lhr-solar/VCAT-StrainGaugeBoard/StrainGaugeBoard.pdf

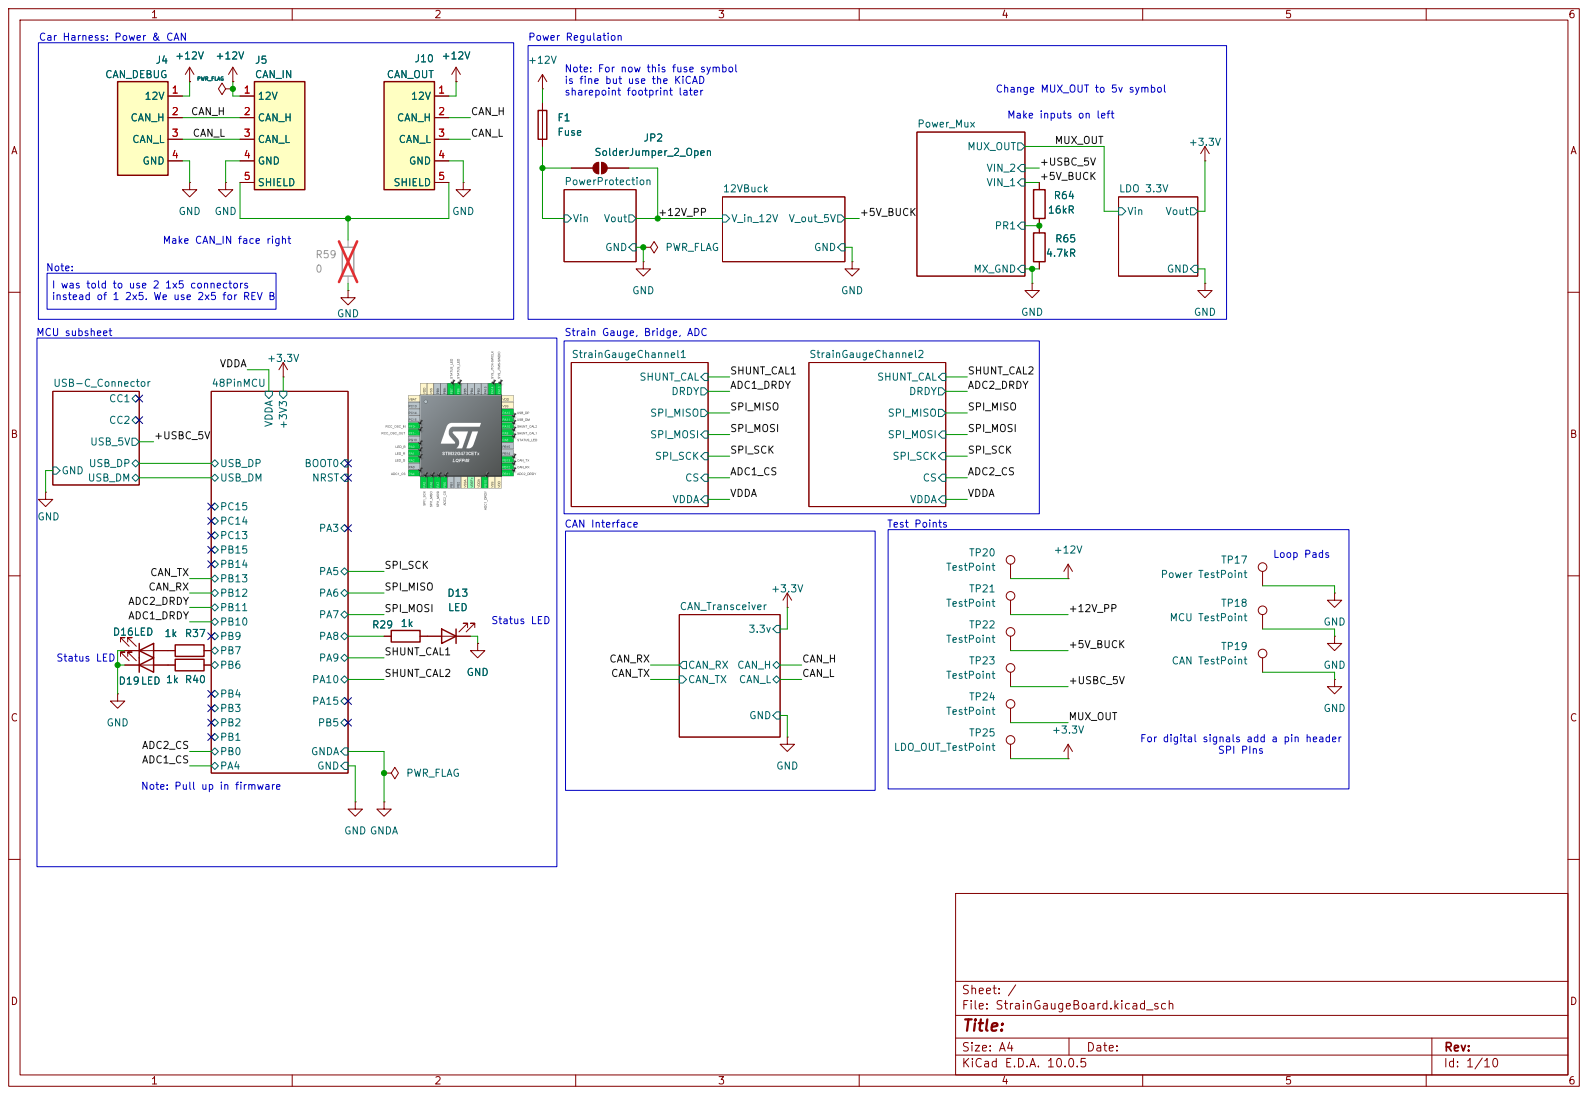
[picture p1: page 1]

Car Harness: Power & CAN

Note: For now this fuse symbol

I was told to use 2 1x5 connectors

Test Points Strain Gauge, Bridge, ADC

For digital signals add a pin header SPI PIns

Note: Pull up in firmware

Size: A4 | Rev:
KiCad E.D.A. 10.0.5 | Id: 1/10

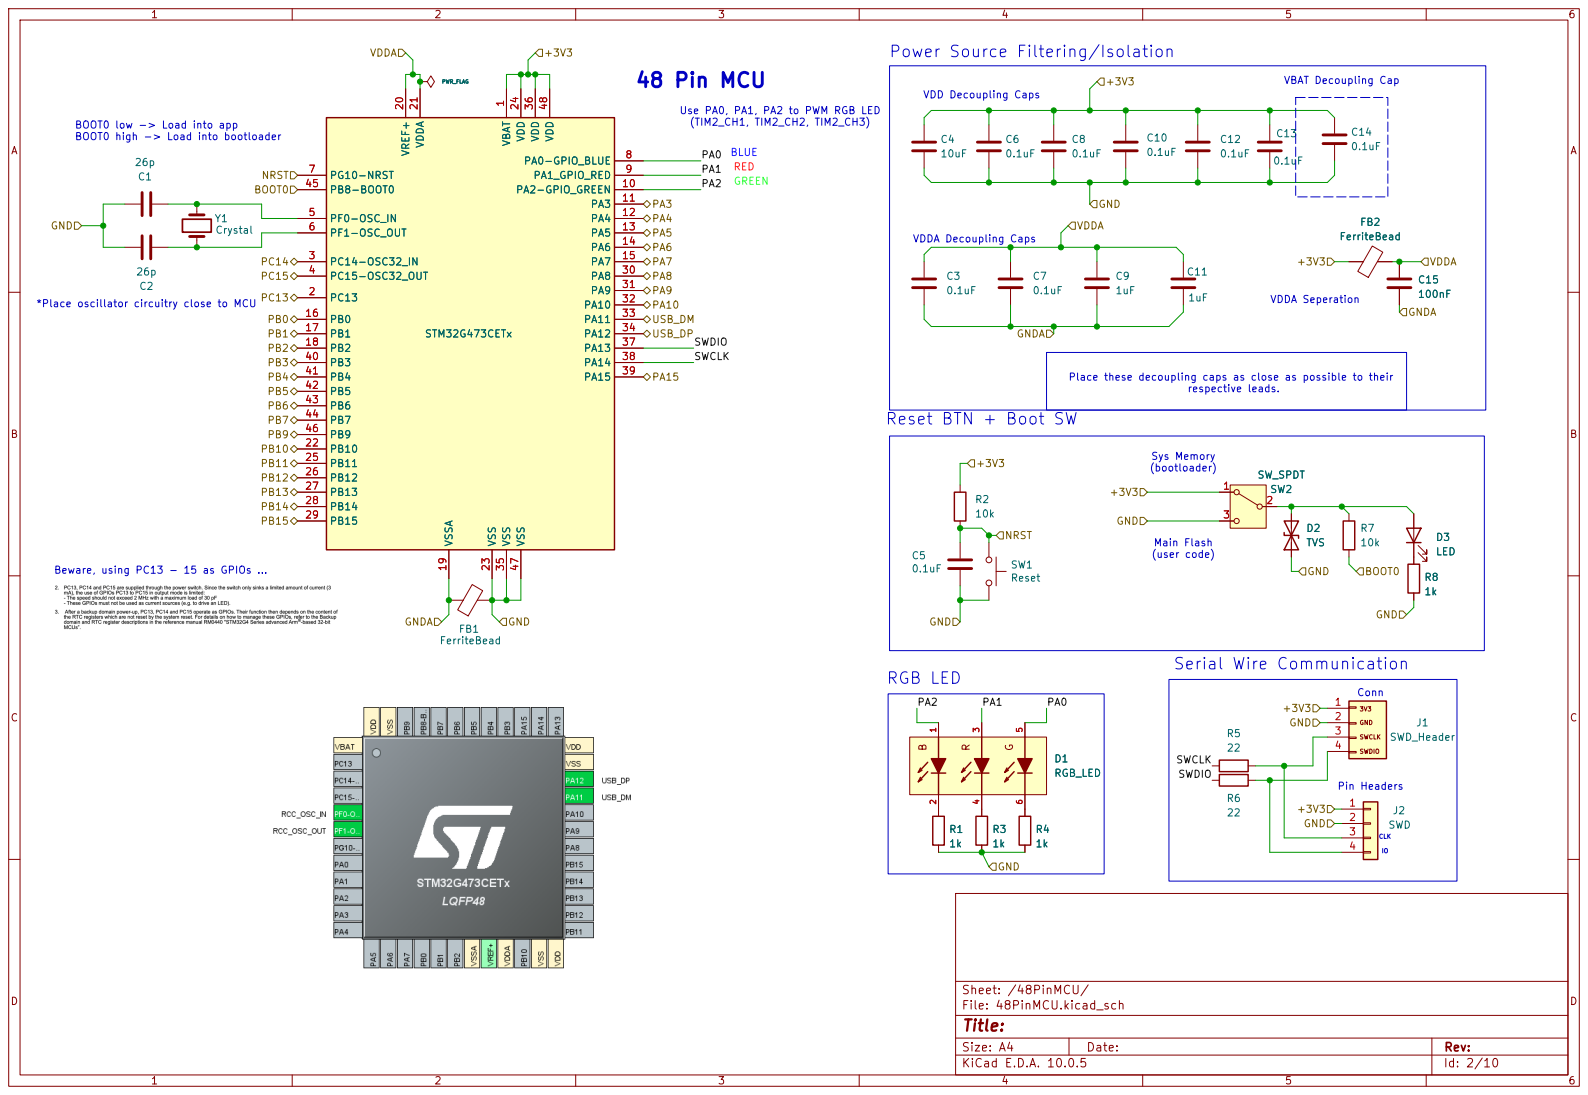
[picture p2: page 2]

*Place oscillator circuitry close to MCU

Place these decoupling caps as close as possible to their

respective leads. Sys Memory

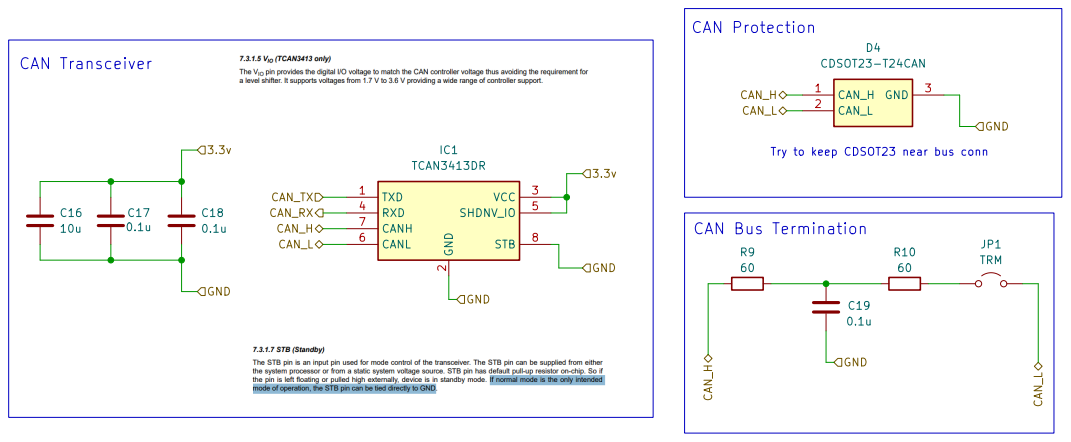
[picture p3: page 3]

Try to keep CDSOT23 near bus conn CAN Bus Termination

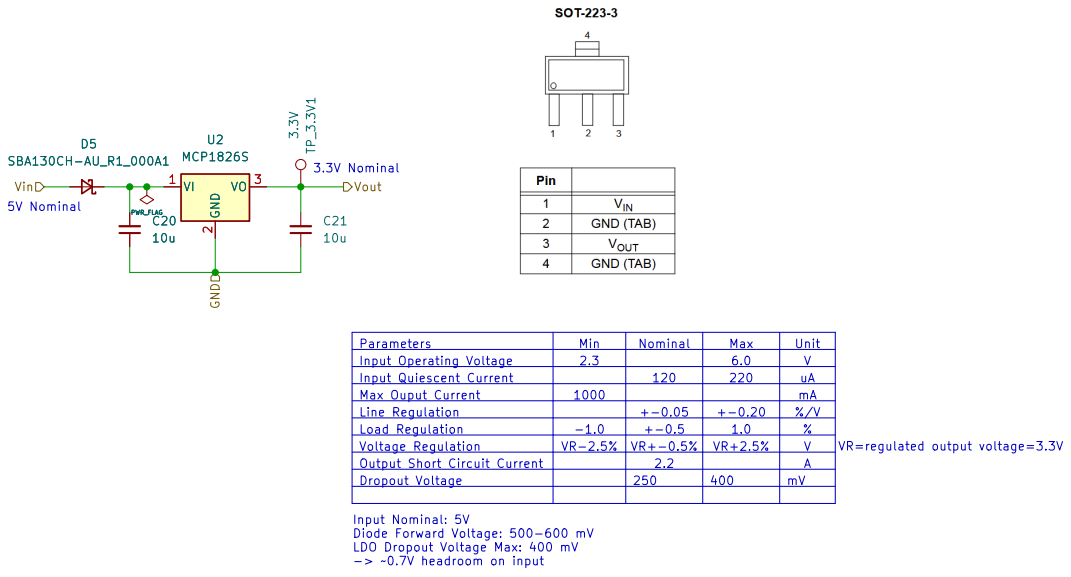
[picture p4: page 4]

VR=regulated output voltage=3.3V 3.3V Nominal D5

Input Operating Voltage | 2.3 | | 6.0 | V
Input Quiescent Current | 1000 | 120 | 220 | mA uA Max Ouput Current

Line Regulation | | +-0.05 | +-0.20 | %/V
Load Regulation | -1.0 | +-0.5 | 1.0 | %

Input Nominal: 5V Diode Forward Voltage: 500-600 mV

LDO Dropout Voltage Max: 400 mV -> ~0.7V headroom on input

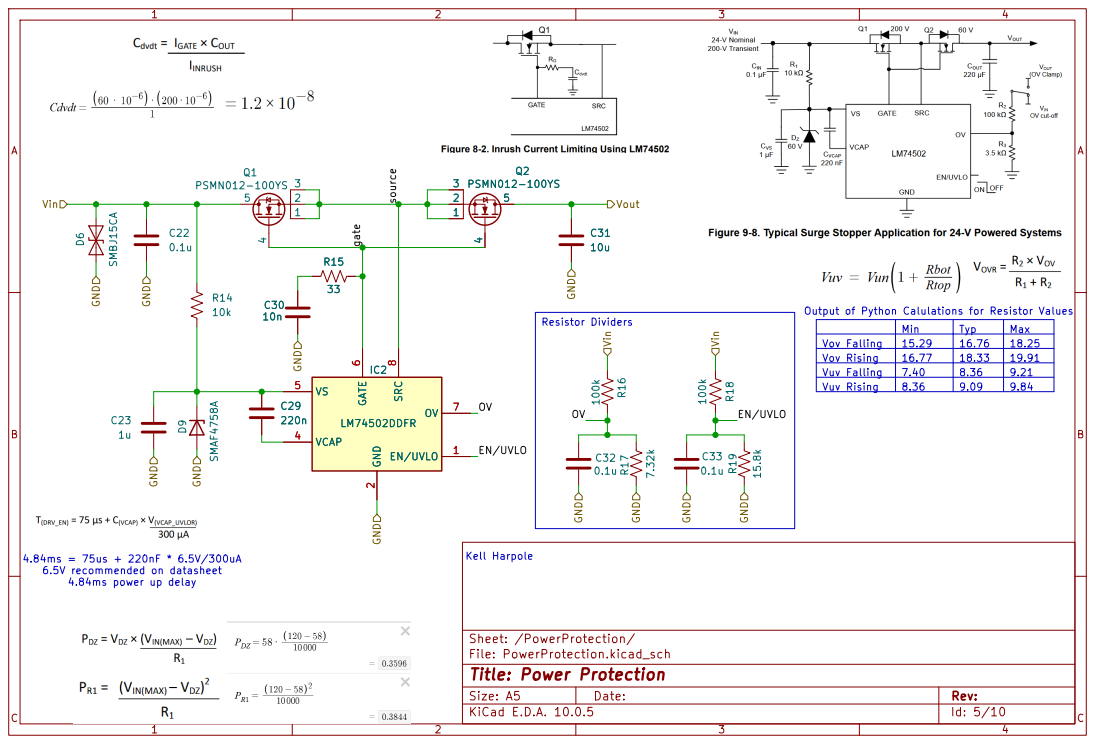
[picture p5: page 5]

Output of Python Calulations for Resistor Values C29

Vov Rising | 16.77 | 18.33 | 19.91
Vuv Falling | 7.40 | 8.36 | 9.21

Size: A5 | Rev: | C Date:
KiCad E.D.A. 10.0.5 | Id: 5/10

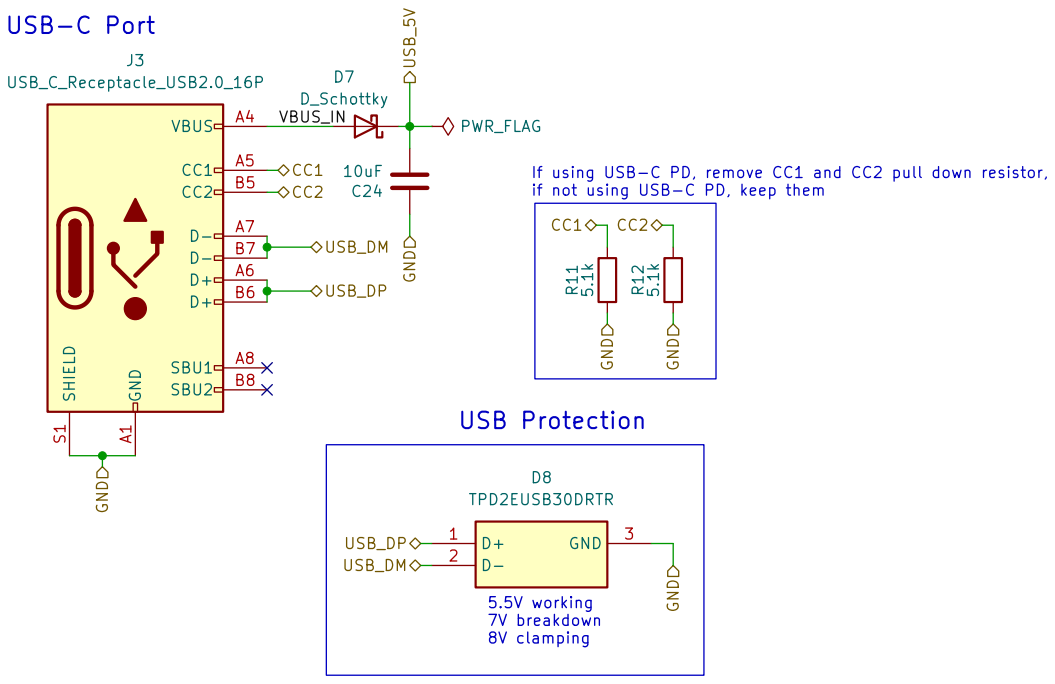
[picture p6: page 6]

If using USB-C PD, remove CC1 and CC2 pull down resistor,
if not using USB-C PD, keep them

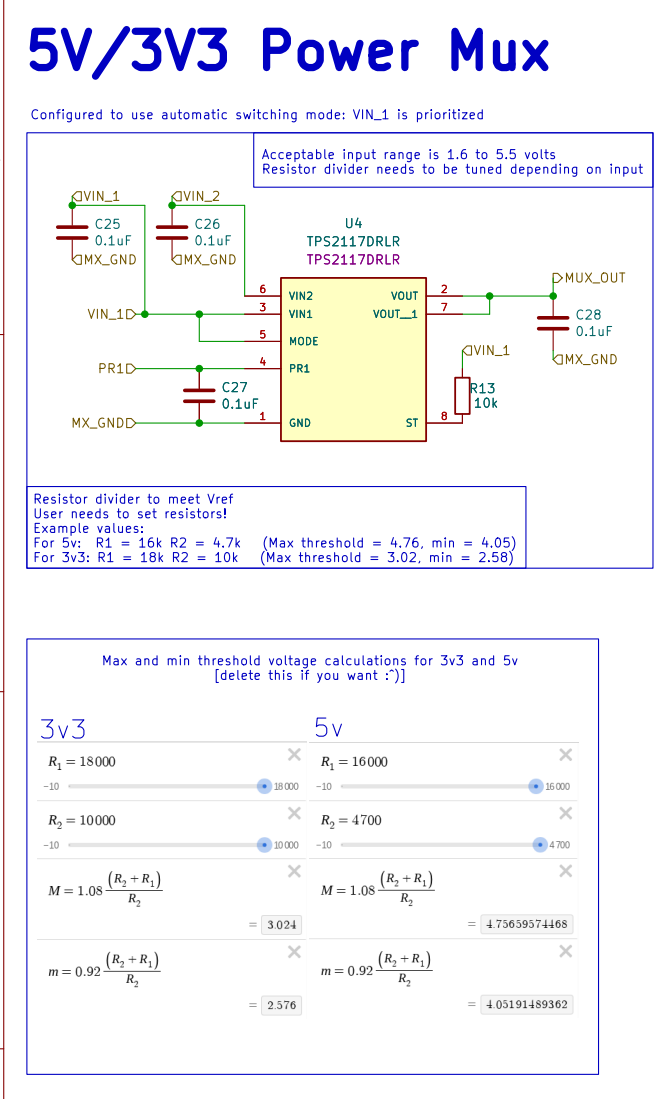
[picture p7: page 7]

Configured to use automatic switching mode: VIN_1 is prioritized Max and min threshold voltage calculations for 3v3 and 5v

Acceptable input range is 1.6 to 5.5 volts Resistor divider needs to be tuned depending on input
TPS2117DRLR

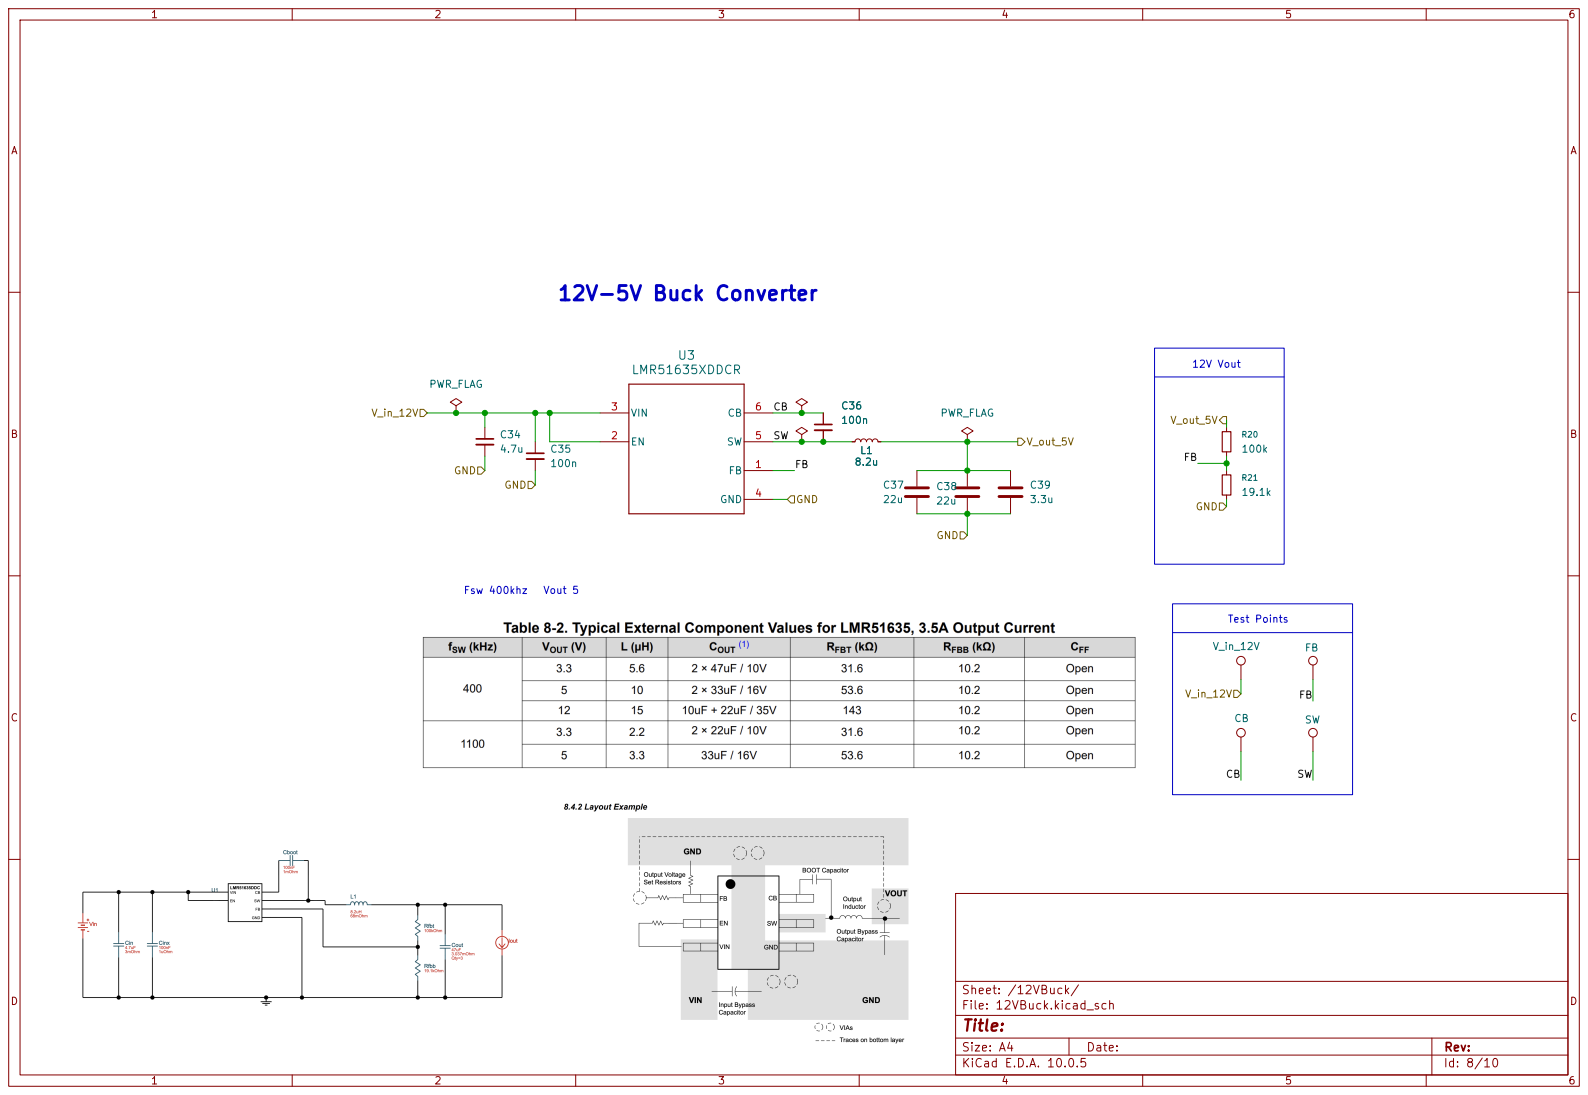
[picture p8: page 8]

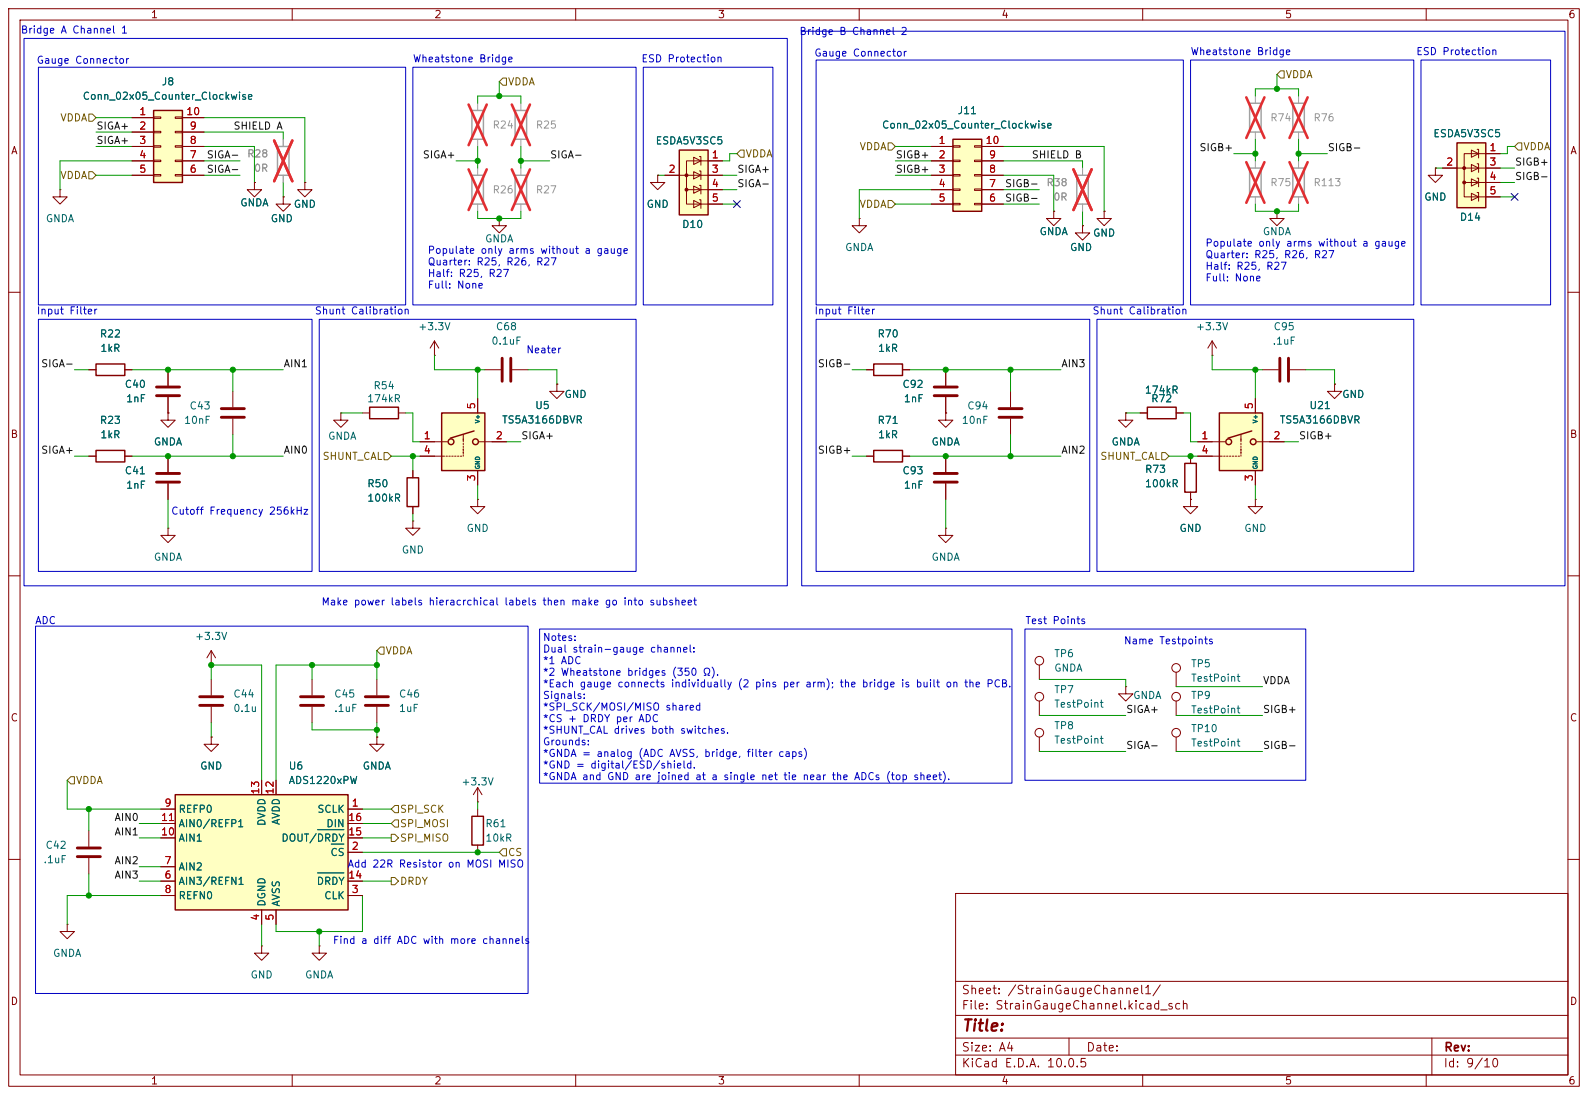
[picture p9: page 9]

Populate only arms without a gauge Quarter: R25, R26, R27 Half: R25, R27

*GNDA = analog (ADC AVSS, bridge, filter caps) *GND = digital/ESD/shield. *GNDA and GND are joined at a single net tie near the ADCs (top sheet). Neater

Notes: Dual strain-gauge channel: *1 ADC

*2 Wheatstone bridges (350 Ω). *Each gauge connects individually (2 pins per arm); the bridge is built on the PCB. Signals:

*SPI_SCK/MOSI/MISO shared
*CS + DRDY per ADC
*SHUNT_CAL drives both switches. Grounds:

Add 22R Resistor on MOSI MISO

Find a diff ADC with more channels

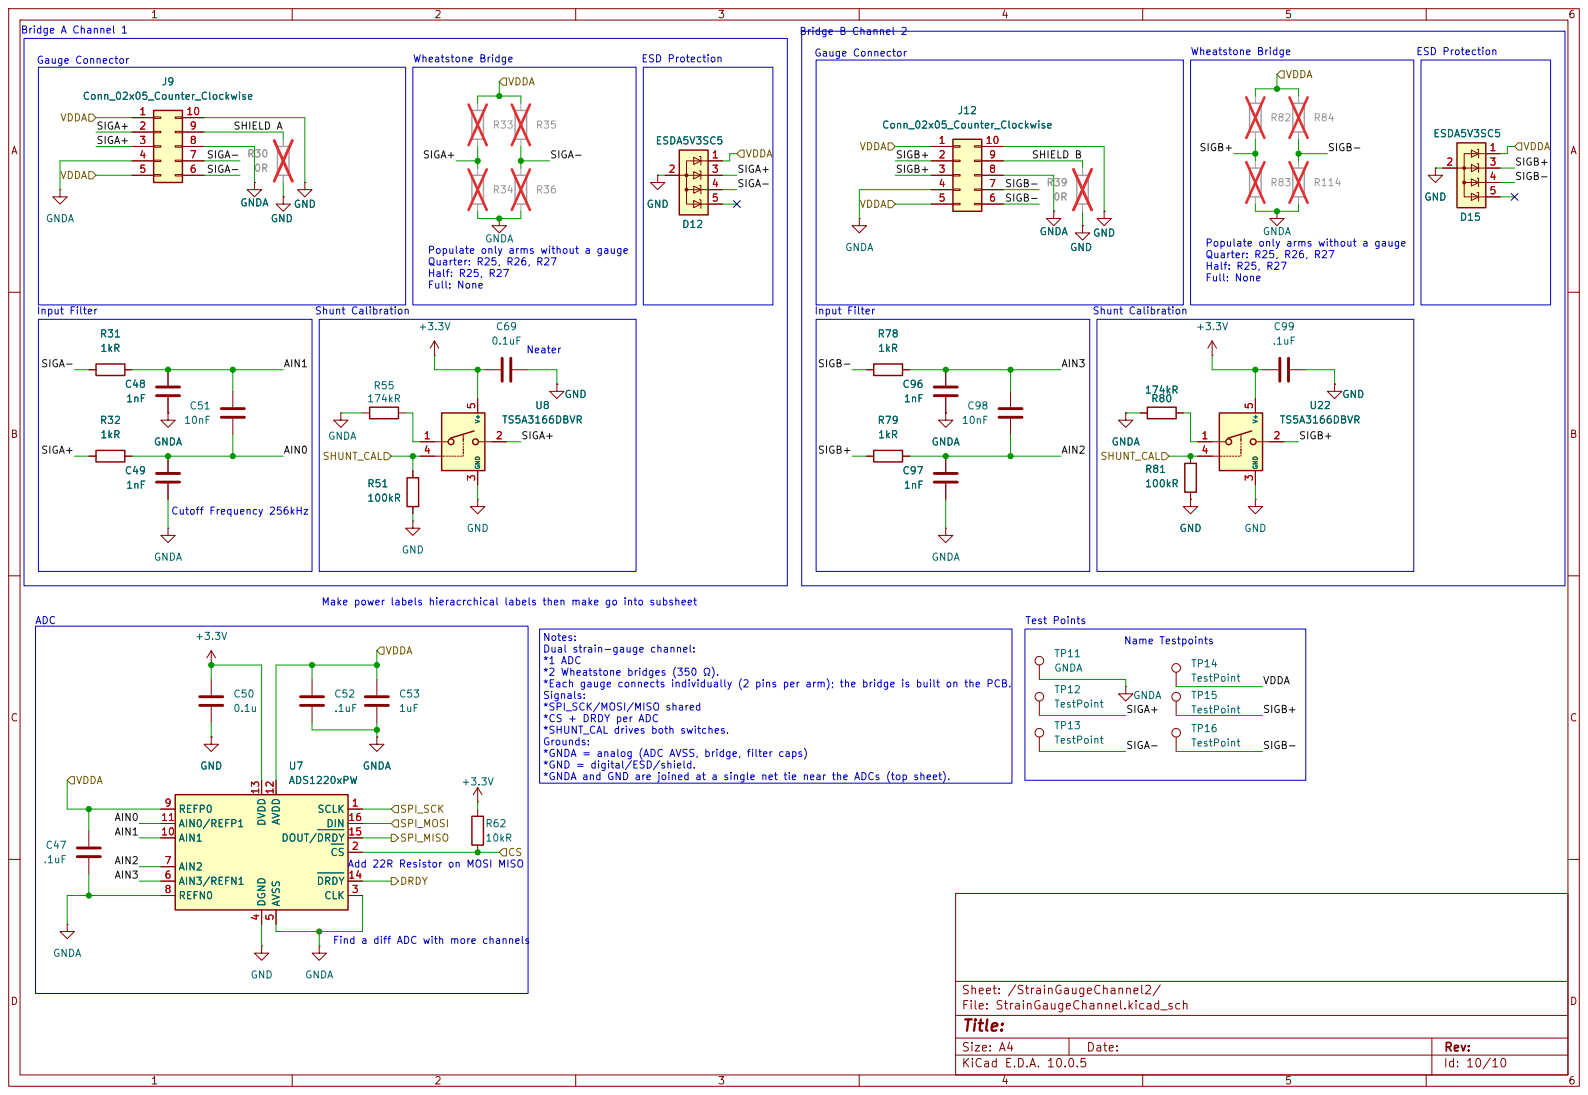
[picture p10: page 10]

Full: None Wheatstone Bridge

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

Notes: Dual strain-gauge channel: *1 ADC

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

*SPI_SCK/MOSI/MISO shared
*CS + DRDY per ADC
*SHUNT_CAL drives both switches. Grounds:

Add 22R Resistor on MOSI MISO
