lhr-solar/VCAT-StrainGaugeBoard/hardware/StrainGaugeBoard.kicad_pcb

## KiCad design hardware/StrainGaugeBoard.kicad_pcb (2026-11-10)

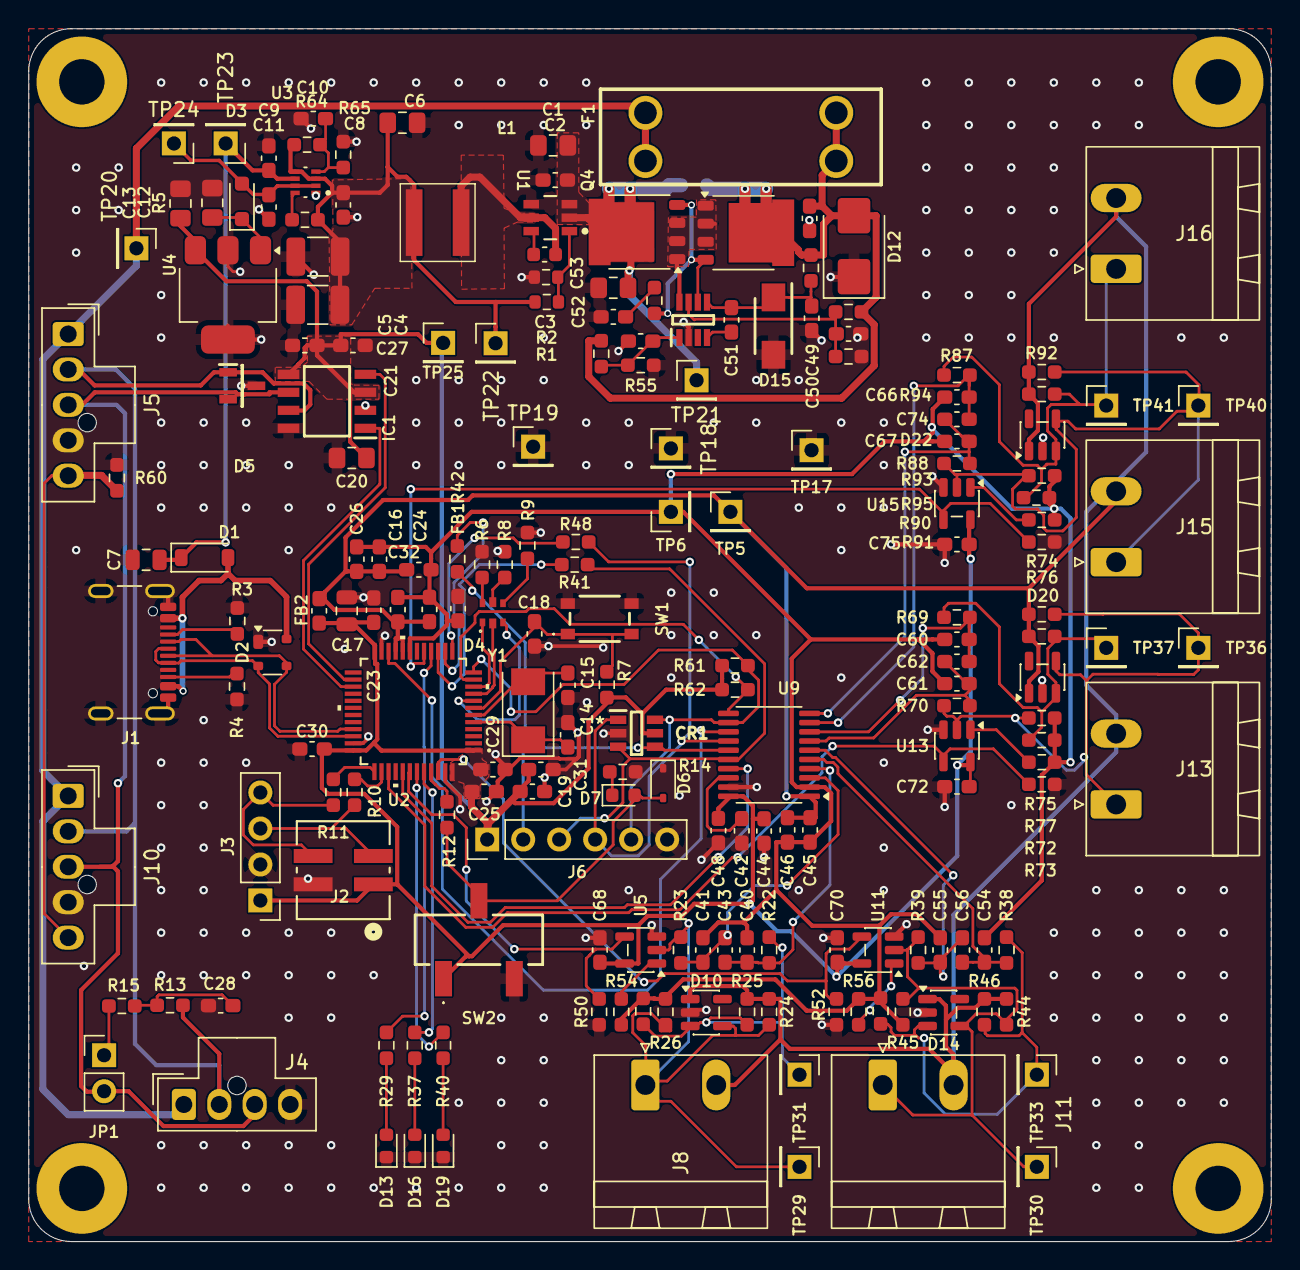
[picture p11: board StrainGaugeBoard.kicad_pcb from above]

Board: 2 copper layers, 87.7 x 85.6 mm, 198 parts (1 on the bottom side), 92 nets.

Parts:
C1: 4.7u; C_0805_2012Metric_Pad1.18x1.45mm_HandSolder
C2: 100n; C_0603_1608Metric_Pad1.08x0.95mm_HandSolder
C3: 100n; C_0603_1608Metric
C4, C5: 22u; C_1210_3225Metric_Pad1.33x2.70mm_HandSolder
C6: 3.3u; C_0805_2012Metric_Pad1.18x1.45mm_HandSolder
C7: 10u; C_0805_2012Metric
C8, C9, C10, C11, C21, C27, C28, C45, C48, C49, C57, C58, C68, C70, C72, C75: 0.1u; C_0603_1608Metric_Pad1.08x0.95mm_HandSolder
C12, C13, C20, C53: 10u; C_0805_2012Metric_Pad1.18x1.45mm_HandSolder
C14, C15: 26p; C_0603_1608Metric_Pad1.08x0.95mm_HandSolder
C16, C18, C19, C22, C23, C25, C29, C30, C31: 0.1uF; C_0603_1608Metric_Pad1.08x0.95mm_HandSolder
C17: 10uF; C_0805_2012Metric
C24, C26: 1uF; C_0603_1608Metric_Pad1.08x0.95mm_HandSolder
C32: 100nF; C_0603_1608Metric_Pad1.08x0.95mm_HandSolder
C40, C41, C54, C55, C60, C61, C66, C67: 1n; C_0603_1608Metric_Pad1.08x0.95mm_HandSolder
C42, C51: 220n; C_0603_1608Metric_Pad1.08x0.95mm_HandSolder
C43, C52, C56, C62, C74: 10n; C_0603_1608Metric_Pad1.08x0.95mm_HandSolder
C44, C46, C50: 1u; C_0603_1608Metric_Pad1.08x0.95mm_HandSolder
CR1: D5V0P4UR6SO-7
D1: D_Schottky; D_SOD-123
D2: SP0503BAHT; SOT-143
D3: SBA130CH-AU_R1_000A1; D_SOD-323_HandSoldering
D4: RGB_LED
D5: CDSOT23-T24CAN
D6: TVS; D_SOD-323
D7, D13, D16, D19: LED; LED_0603_1608Metric
D10, D14, D20, D22: ESDA5V3SC5; SOT-23-5
D12: SMBJ15CA; D_SMB
D15: SMAF4758A; SODFL5026X125N
F1: 1A; Fuse-3557-2
FB1, FB2: FerriteBead; C_0603_1608Metric_Pad1.08x0.95mm_HandSolder
H1, H2, H3, H4: MountingHole_3.2mm_M3_Pad
IC1: TCAN3413DR
IC3: LM74502DDFR
J1: USB_C_Receptacle_USB2.0_16P; USB_C_Receptacle_GCT_USB4105-xx-A_16P_TopMnt_Horizontal
J2: SWD_Header; SWD_Conn
J3: SWD; PinHeader_1x04_P2.54mm_Vertical
J4: CAN_DEBUG; Molex_Nano-Fit_105309-xx04_1x04_P2.50mm_Vertical
J5: CAN_IN; Molex_Nano-Fit_105309-xx05_1x05_P2.50mm_Vertical
J6: Conn_01x06; PinHeader_1x06_P2.54mm_Vertical
J8, J11, J13: Gauge; PhoenixContact_MSTBA_2,5_2-G_1x02_P5.00mm_Horizontal
J10: CAN_OUT; Molex_Nano-Fit_105309-xx05_1x05_P2.50mm_Vertical
J15: Gauge A; PhoenixContact_MSTBA_2,5_2-G_1x02_P5.00mm_Horizontal
J16: Gauge B; PhoenixContact_MSTBA_2,5_2-G_1x02_P5.00mm_Horizontal
JP1: TRM; PinHeader_1x02_P2.54mm_Vertical
JP2: SolderJumper_2_Open; SolderJumper-2_P1.3mm_Open_RoundedPad1.0x1.5mm
L1: 8.2u; XAL5050822MEC
Q3, Q4: PSMN012-100YS; LFPAK56
R1: 100k; R_0603_1608Metric
R2: 19.1k; R_0603_1608Metric
R3, R4: 5.1k; R_0603_1608Metric_Pad0.98x0.95mm_HandSolder
R5, R7, R12, R35, R61, R62: 10k; R_0603_1608Metric_Pad0.98x0.95mm_HandSolder
R6, R8, R9, R14, R22, R23, R29, R37, R38, R39, R40, R69, R70, R87, R88: 1k; R_0603_1608Metric_Pad0.98x0.95mm_HandSolder
R10, R11, R41, R42, R48: 22; R_0603_1608Metric_Pad0.98x0.95mm_HandSolder
R13, R15: 60; R_0603_1608Metric_Pad0.98x0.95mm_HandSolder
R24, R25, R26, R27, R44, R45, R46, R47, R74, R75, R76, R77, R92, R93, R94, R95: 350; R_0603_1608Metric_Pad0.98x0.95mm_HandSolder
R36: 33; R_0603_1608Metric_Pad0.98x0.95mm_HandSolder
R49, R50, R52, R53, R73, R91: 100k; R_0603_1608Metric_Pad0.98x0.95mm_HandSolder
R51: 7.32k; R_0603_1608Metric_Pad0.98x0.95mm_HandSolder
R54, R56, R72, R90: 174k; R_0603_1608Metric_Pad0.98x0.95mm_HandSolder
R55: 15.8k; R_0603_1608Metric_Pad0.98x0.95mm_HandSolder
R60: 0; R_0603_1608Metric_Pad0.98x0.95mm_HandSolder
R64: 16k; R_0603_1608Metric_Pad0.98x0.95mm_HandSolder
R65: 4.7k; R_0603_1608Metric_Pad0.98x0.95mm_HandSolder
SW1: Reset; TL3365AF180QG
SW2: SW_SPDT; BootSW
TP5: VDDA; PinHeader_1x01_P2.54mm_Vertical
TP6: GNDA; PinHeader_1x01_P2.54mm_Vertical
TP17: Power TestPoint; PinHeader_1x01_P2.54mm_Vertical
TP18: MCU TestPoint; PinHeader_1x01_P2.54mm_Vertical
TP19: CAN TestPoint; PinHeader_1x01_P2.54mm_Vertical
TP20: +12V; PinHeader_1x01_P2.54mm_Vertical
TP21: +12V_PP; PinHeader_1x01_P2.54mm_Vertical
TP22: +5V_BUCK; PinHeader_1x01_P2.54mm_Vertical
TP23: +USBC_5V; PinHeader_1x01_P2.54mm_Vertical
TP24: MUX_OUT; PinHeader_1x01_P2.54mm_Vertical
TP25: LDO_OUT_TestPoint; PinHeader_1x01_P2.54mm_Vertical
TP29, TP30, TP36, TP40: SIG+; PinHeader_1x01_P2.54mm_Vertical
TP31, TP33, TP37, TP41: SIG-; PinHeader_1x01_P2.54mm_Vertical
U1: LMR51635XDDCR; DDC0006A-MFG
U2: STM32G473CETx; 48PinMCU
U3: TPS2117DRLR
U4: MCP1826S; SOT-223-3_TabPin2
U5, U11, U13, U15: TS5A3166DBVR; SOT-23-5
U9: ADS131M04xPW; TSSOP-20_4.4x6.5mm_P0.65mm
Y1: Crystal; Crystal_SMD_Abracon_ABM3-2Pin_5.0x3.2mm

Connections:
+3.3V: C13.2, C17.1, C19.1, C20.1, C21.1, C23.1, C25.1, C27.1, C29.1, C30.1, C31.1, C44.1, C48.1, C68.2, C70.2, C72.2, C75.2, CR1.5, FB2.1, IC1.3 (VCC), IC1.5 (SHDNV_IO), J2.1, J3.1, J6.1, R7.2, R61.1, R62.1, SW2.1 (A), TP25.1 (1_1), U2.1 (VBAT), U2.24 (VDD), U2.36 (VDD), U2.48 (VDD), U4.3 (VO), U5.5 (V+), U9.20 (DVDD), U11.5 (V+), U13.5 (V+), U15.5 (V+)
+5V: C11.1, D3.2 (A), TP24.1 (1_1), U3.2 (VOUT), U3.7 (VOUT__1)
+12V: F1.1, J4.1 (12V), J5.1 (12V), J10.1 (12V), TP20.1 (1_1)
/12VBuck/CB: C3.1, U1.6 (CB)
/12VBuck/FB: R1.2, R2.1, U1.1 (FB)
/12VBuck/SW: C3.2, L1.1, U1.5 (SW)
/48PinMCU/BOOT0: R12.1, U2.45 (PB8-BOOT0)
/48PinMCU/NRST: C18.1, R7.1, SW1.1, U2.7 (PG10-NRST)
/48PinMCU/PA0: D4.5, U2.8 (PA0-GPIO_BLUE)
/48PinMCU/PA1: D4.3, U2.9 (PA1_GPIO_RED)
/48PinMCU/PA2: D4.1, U2.10 (PA2-GPIO_GREEN)
/48PinMCU/PA5: R48.1, U2.13 (PA5)
/48PinMCU/PA6: R42.1, U2.14 (PA6)
/48PinMCU/PA7: R41.1, U2.15 (PA7)
/48PinMCU/PB0: R29.1, U2.16 (PB0)
/48PinMCU/PB6: R40.1, U2.43 (PB6)
/48PinMCU/PB7: R37.1, U2.44 (PB7)
/48PinMCU/SWCLK: R10.1, U2.38 (PA14)
/48PinMCU/SWDIO: R11.1, U2.37 (PA13)
/48PinMCU/USB_DM: D2.3 (K), J1.A7 (D-), J1.B7 (D-), U2.33 (PA11)
/48PinMCU/USB_DP: D2.2 (K), J1.A6 (D+), J1.B6 (D+), U2.34 (PA12)
/+5V_BUCK: C4.1, C5.1, C6.1, C8.1, L1.2, R1.1, R5.1, R64.1, TP22.1 (1_1), U3.3 (VIN1), U3.5 (MODE)
/+12V_PP: C1.1, C2.1, C53.1, JP2.2 (B), Q4.5, TP21.1 (1_1), U1.2 (EN), U1.3 (VIN)
/+USBC_5V: C7.2, C9.1, D1.1 (K), TP23.1 (1_1), U3.6 (VIN2)
/ADC_CLKIN: U2.41 (PB4), U9.17 (CLKIN)
/ADC_CS: CR1.6, J6.5, R61.2, U2.12 (PA4), U9.12 (~CS)
/ADC_DRDY: U2.22 (PB10), U9.13 (~DRDY)
/ADC_SYNC_RST: R62.2, U2.11 (PA3), U9.11 (~SYNC/~RESET)
/CAN_H: D5.1 (CAN_H), IC1.7 (CANH), J4.2 (CAN_H), J5.2 (CAN_H), J10.2 (CAN_H), R13.1
/CAN_L: D5.2 (CAN_L), IC1.6 (CANL), J4.3 (CAN_L), J5.3 (CAN_L), J10.3 (CAN_L), JP1.2 (B)
/CAN_RX: IC1.4 (RXD), U2.26 (PB12)
/CAN_TX: IC1.1 (TXD), U2.27 (PB13)
/PowerProtection/EN/UVLO: C58.1, IC3.1 (EN/UVLO), R53.2, R55.2
/PowerProtection/OV: C57.1, IC3.7 (OV), R49.2, R51.1
/PowerProtection/Vin: C49.1, D12.2 (A2), F1.2, JP2.1 (A), Q3.5, R35.2, R49.1, R53.1
/PowerProtection/gate: IC3.6 (GATE), Q3.4, Q4.4, R36.2
/PowerProtection/source: IC3.8 (SRC), Q3.1, Q3.2, Q3.3, Q4.1, Q4.2, Q4.3
/Power_Mux/PR1: C10.1, R64.2, R65.1, U3.4 (PR1)
/SHUNT_CAL0: R50.1, U2.42 (PB5), U5.4
/SHUNT_CAL1: R52.1, U2.46 (PB9), U11.4
/SHUNT_CAL2: R73.1, U2.39 (PA15), U13.4
/SHUNT_CAL3: R91.1, U2.17 (PB1), U15.4
/SPI_MISO: CR1.4, J6.2, R42.2, U9.15 (DOUT)
/SPI_MOSI: CR1.3, J6.3, R41.2, U9.16 (DIN)
/SPI_SCK: CR1.1, J6.4, R48.2, U9.14 (SCLK)
/StrainADC/AIN0N: C40.2, C43.2, R22.2, U9.4 (AIN0N)
/StrainADC/AIN0P: C41.2, C43.1, R23.2, U9.3 (AIN0P)
/StrainADC/AIN1N: C54.2, C56.2, R38.2, U9.5 (AIN1N)
/StrainADC/AIN1P: C55.2, C56.1, R39.2, U9.6 (AIN1P)
/StrainADC/AIN2N: C60.2, C62.2, R69.2, U9.8 (AIN2N)
/StrainADC/AIN2P: C61.2, C62.1, R70.2, U9.7 (AIN2P)
/StrainADC/AIN3N: C66.2, C74.2, R87.2, U9.9 (AIN3N)
/StrainADC/AIN3P: C67.2, C74.1, R88.2, U9.10 (AIN3P)
/StrainADC/StrainChannel0/SIG+: D10.4 (K), J8.1, R23.1, R24.2, R26.1, TP29.1 (1_1), U5.2
/StrainADC/StrainChannel0/SIG-: D10.3 (K), R22.1, R25.2, R27.1, TP31.1 (1_1)
/StrainADC/StrainChannel1/SIG+: D14.4 (K), J11.1, R39.1, R44.2, R45.1, TP30.1 (1_1), U11.2
/StrainADC/StrainChannel1/SIG-: D14.3 (K), R38.1, R46.2, R47.1, TP33.1 (1_1)
/StrainADC/StrainChannel2/SIG+: D20.4 (K), J13.1, R70.1, R74.2, R75.1, TP36.1 (1_1), U13.2
/StrainADC/StrainChannel2/SIG-: D20.3 (K), R69.1, R76.2, R77.1, TP37.1 (1_1)
/StrainADC/StrainChannel3/SIG+: D22.4 (K), J15.1, R88.1, R92.2, R93.1, TP40.1 (1_1), U15.2
/StrainADC/StrainChannel3/SIG-: D22.3 (K), J16.1, R87.1, R94.2, R95.1, TP41.1 (1_1)
/USB-C_Connector/CC1: J1.A5 (CC1), R3.2
/USB-C_Connector/CC2: J1.B5 (CC2), R4.2
/USB-C_Connector/VBUS_IN: D1.2 (A), D2.4 (K), J1.A4 (VBUS), J1.A9 (VBUS), J1.B4 (VBUS), J1.B9 (VBUS)
/VDDA: C16.1, C22.1, C24.1, C26.1, C32.1, C45.1, C46.1, D10.1 (K), D14.1 (K), D20.1 (K), D22.1 (K), FB2.2, J8.2, J11.2, J13.2, J15.2, J16.2, R24.1, R25.1, R44.1, R46.1, R74.1, R76.1, R92.1, R94.1, TP5.1 (1_1), U2.20 (VREF+), U2.21 (VDDA), U9.1 (AVDD)
GND: C1.2, C2.2, C4.2, C5.2, C6.2, C7.1, C8.2, C9.2, C10.2, C11.2, C12.1, C13.1, C14.1, C15.2, C17.2, C18.2, C19.2, C20.2, C21.2, C23.2, C25.2, C27.2, C28.1, C29.2, C30.2, C31.2, C42.2, C44.2, C48.2, C49.2, C50.1, C52.2, C53.2, C57.2, C58.2, C68.1, C70.1, C72.1, C75.1, CR1.2, D2.1 (A), D5.3 (GND), D6.1 (A1), D10.2 (A), D12.1 (A1), D13.1 (K), D14.2 (A), D15.2 (A), D16.1 (K), D19.1 (K), D20.2 (A), D22.2 (A), FB1.2, IC1.2 (GND), IC1.8 (STB), IC3.2 (GND), J1.A1 (GND), J1.A12 (GND), J1.B1 (GND), J1.B12 (GND), J1.S1 (SHIELD), J1.S2 (Shield), J1.S3 (Shield), J1.S4 (Shield), J2.2, J3.2, J4.4 (GND), J5.4 (GND), J6.6, J10.4 (GND), R2.2, R3.1, R4.1, R6.2, R8.2, R9.2, R14.2, R50.2, R51.2, R52.2, R55.1, R60.2, R65.2, R73.2, R91.2, SW1.2, SW2.3 (C), TP17.1 (1_1), TP18.1 (1_1), TP19.1 (1_1), U1.4 (GND), U2.23 (VSS), U2.35 (VSS), U2.47 (VSS), U3.1 (GND), U4.2 (GND), U5.3 (GND), U9.19 (DGND), U11.3 (GND), U13.3 (GND), U15.3 (GND)
GNDA: C16.2, C22.2, C24.2, C26.2, C32.2, C40.1, C41.1, C45.2, C46.2, C54.1, C55.1, C60.1, C61.1, C66.1, C67.1, FB1.1, R26.2, R27.2, R45.2, R47.2, R54.2, R56.2, R72.2, R75.2, R77.2, R90.2, R93.2, R95.2, TP6.1 (1_1), U2.19 (VSSA), U9.2 (AGND)
unnamed: C28.2, R13.2, R15.1
unnamed: C52.1, R36.1
unnamed: C12.2, D3.1 (K), U4.1 (VI)
unnamed: D4.2, R6.1
unnamed: D4.4, R8.1
unnamed: D4.6, R9.1
unnamed: D6.2 (A2), D7.2 (A), R12.2, SW2.2 (B)
unnamed: D7.1 (K), R14.1
unnamed: D13.2 (A), R29.2
unnamed: C50.2, C51.1, D15.1 (K), IC3.5 (VS), R35.1
unnamed: D16.2 (A), R37.2
unnamed: D19.2 (A), R40.2
unnamed: C51.2, IC3.4 (VCAP)
unnamed: J2.3, J3.3, R10.2
unnamed: J2.4, J3.4, R11.2
unnamed: J5.5 (SHIELD), J10.5 (SHIELD), R60.1
unnamed: JP1.1 (A), R15.2
unnamed: R54.1, U5.1
unnamed: R56.1, U11.1
unnamed: R72.1, U13.1
unnamed: R90.1, U15.1
unnamed: C14.2, U2.5 (PF0-OSC_IN), Y1.1
unnamed: C15.1, U2.6 (PF1-OSC_OUT), Y1.2
unnamed: R5.2, U3.8 (ST)
unnamed: C42.1, U9.18 (CAP)
