lhr-solar/VCAT-StrainGaugeBoard/CubeMX/CubeMX.ioc

Mcu.UserName=STM32G473CETx
PA0.GPIO_Label=LED_B
PA0.Signal=S_TIM2_CH1
PA1.GPIO_Label=LED_R
PA1.Signal=S_TIM2_CH2
PA10.GPIO_Label=SHUNT_CAL2
PA10.Signal=GPIO_Output
PA11.Signal=USB_DM
PA12.Signal=USB_DP
PA13.Signal=SYS_JTMS-SWDIO
PA14.Signal=SYS_JTCK-SWCLK
PA2.GPIO_Label=LED_G
PA2.Signal=S_TIM2_CH3
PA4.GPIO_Label=ADC1_CS
PA4.Signal=GPIO_Output
PA5.Signal=SPI1_SCK
PA6.Signal=SPI1_MISO
PA7.Signal=SPI1_MOSI
PA8.GPIO_Label=STATUS_LED1
PA8.Signal=GPIO_Output
PA9.GPIO_Label=SHUNT_CAL1
PA9.Signal=GPIO_Output
PB0.GPIO_Label=ADC2_CS
PB0.Signal=GPIO_Output
PB10.GPIO_Label=ADC1_DRDY
PB10.Signal=GPXTI10
PB11.GPIO_Label=ADC2_DRDY
PB11.Signal=GPXTI11
PB12.GPIO_Label=CAN_RX
PB12.Signal=FDCAN2_RX
PB13.GPIO_Label=CAN_TX
PB13.Signal=FDCAN2_TX
PB6.GPIO_Label=STATUS_LED2
PB6.Signal=GPIO_Output
PB7.GPIO_Label=STATUS_LED3
PB7.Signal=GPIO_Output
PF0-OSC_IN.Signal=RCC_OSC_IN
PF1-OSC_OUT.Signal=RCC_OSC_OUT
