lhr-solar/VCAT-StrainGaugeBoard/(commit log)

2026-10-03 file refactor
    [StrainGaugeBoard.kicad_pcb, StrainGaugeBoard.kicad_sch]
2026-10-03 added KiCAD sharpoint
2026-10-03 skill issue
    [12VBuck.kicad_sch, 48PinMCU.kicad_sch, CAN_Transceiver.kicad_sch, LDO.kicad_sch, PowerProtection.kicad_sch, Power_Mux.kicad_sch, USB-C_Connector.kicad_sch]
2026-10-04 Strain gauge schematic: 4 channels, on-board bridge, shunt-cal, power + CAN
    [untitled.kicad_sch]
2026-10-04 Remove .history, add .gitignore, rename channel sheet to StrainGaugeChannel.kicad_sch
    [StrainGaugeChannel.kicad_sch, untitled.kicad_sch]
2026-10-06 sath rev
    [StrainGaugeChannel.kicad_sch]
2026-10-07 Update power mux and strain gauge channel schematics
    [Power_Mux.kicad_sch, StrainGaugeChannel.kicad_sch]
2026-10-07 Fixed ERC
    [12VBuck.kicad_sch, 48PinMCU.kicad_sch, LDO.kicad_sch, PowerProtection.kicad_sch, Power_Mux.kicad_sch, StrainGaugeChannel.kicad_sch]
2026-10-10 ELC review changes implemented
    [48PinMCU.kicad_sch, StrainChannel.kicad_sch, StrainGaugeBoard.kicad_pcb, StrainGaugeChannel.kicad_sch]
2026-10-30 Strain gauge board placement
    - Power, MCU, USB and CAN blocks placed to match the BlackBody layout
    - ADC centred under the MCU, four channel front-ends above their gauge connectors
    - Gauge connectors updated to the schematic's Phoenix MSTBA 5.00 mm footprint, along the bottom edge
    - Board outline 68.2 x 103 mm with 2 mm rounded corners, silkscreen labels
    - Default clearance / hole clearance lowered to 0.15 mm
2026-11-04 power protected
2026-11-08 Strain gauge layout: scattered channels, MCU pin swap, pin-header test points
    - Channels 0/1 on the bottom edge, 2/3 on the right edge, all using the same compact block layout
    - Moved ADC_SYNC_RST (PA3), ADC_CLKIN (PB0), SHUNT_CAL0 (PB5), SHUNT_CAL1 (PB9) to MCU pins facing the ADC and channels
    - Test points switched to 1x01 pin headers (schematic and PCB)
    - Compressed strain section, ADC decoupling moved next to its supply pins
